sadrirammal/PlantMate-Open-Source/Electrical/02_PlantMate_PCB_V2.1 - swapped pumpen anschlüsse/Screenshot_2.png

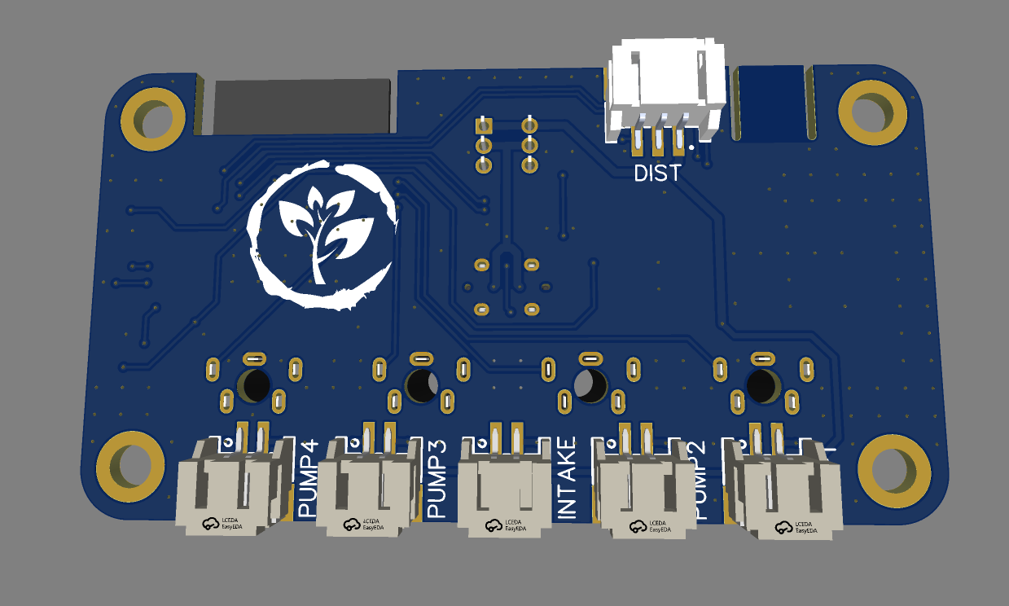
Electrical/02_PlantMate_PCB_V2.1 - swapped pumpen anschlüsse/Screenshot_2.png
