sadrirammal/PlantMate-Open-Source/Electrical/03_Füllstandsensor_V1/Screenshot_1.png

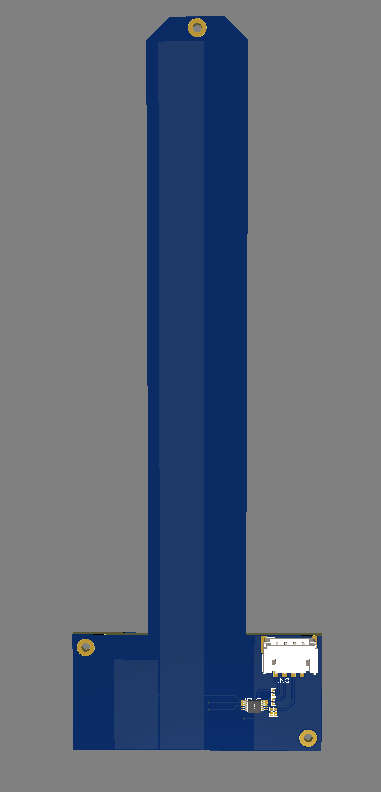
Electrical/03_Füllstandsensor_V1/Screenshot_1.png
