sadrirammal/PlantMate-Open-Source/Electrical/02_PlantMate_PCB_V2.1 - swapped pumpen anschlüsse/BOM.csv

ID | Name | Designator | Footprint | Quantity | Manufacturer Part | Manufacturer | Supplier | Supplier Part
1 | WAFER-PH2.0-2PWB | PUMP1,PUMP2,PUMP3,PUMP4,INTAKE | CONN-SMD_2P-P2.00_XUNPU_WAFER-PH2.0-2PWB | 5 | WAFER-PH2.0-2PWB | XUNPU(讯普) | LCSC | C3029440
2 | WAFER-PH2.0-3PWB | DIST | CONN-SMD_3P-P2.00_XUNPU_WAFER-PH2.0-3PWB | 1 | WAFER-PH2.0-3PWB | XUNPU(讯普) | LCSC | C3029441
3 | 100kΩ | R10,R13,R17,R15,R8 | R0603 | 5 | 0603WAF1003T5E | UNI-ROYAL(厚声) | LCSC | C25803
4 | B5819W | D5,D6,D8,D7,D4 | SOD-123_L2.7-W1.6-LS3.7-RD-1 | 5 | B5819W SL | CJ(江苏长电/长晶) | LCSC | C8598
5 | AO3400A | Q6,Q7,Q9,Q8,Q5 | SOT-23-3_L2.9-W1.3-P1.90-LS2.4-BR | 5 | AO3400A | AOS | LCSC | C20917
6 | TS-1088R-02026 | BOOT,RST | SW-SMD_L3.9-W3.0-P4.45 | 2 | TS-1088R-02026 | XUNPU(讯普) | LCSC | C455280
7 | TYPE-C 24PLT-H10.5 | USB | USB-C_TYPE-C-24PLT-H10.5-1 | 1 | TYPE-C 24PLT-H10.5 | SHOU HAN(首韩) | LCSC | C3151750
8 | 10uF | C10,C5,C4,C9,C1,C2 | C0603 | 6 | CL10A106MA8NRNC | SAMSUNG(三星) | LCSC | C96446
9 | 5.1kΩ | R6,R7 | R0402 | 2 | 0402WGF5101TCE | UniOhm | LCSC | C25905
10 | PJ-358H-B | AUX1,AUX2,AUX3,AUX4 | AUDIO-TH_PJ-358H-B | 4 | PJ-358H-B | XKB Connectivity(中国星坤) | LCSC | C500091
11 | AHT20 | U3 | SENSOR-SMD_L3.0-W3.0-P1.00-BR | 1 | AHT20 | 广州奥松 | LCSC | C2757850
12 | ESP32-WROOM-32E(16MB) | U1 | WIFI-SMD_ESP32-WROOM-32E | 1 | ESP32-WROOM-32E-N16 | ESPRESSIF(乐鑫) | LCSC | C701343
13 | 1MΩ | R22,R21,R20,R19 | R0603 | 4 | 0603WAF1004T5E | UNI-ROYAL(厚声) | LCSC | C22935
14 | CH340C | U7 | SOP-16_L10.0-W3.9-P1.27-LS6.0-BL | 1 | CH340C | WCH | LCSC | C84681
15 | AMS1117-3.3 | U2 | SOT-223-3_L6.5-W3.4-P2.30-LS7.0-BR | 1 | AMS1117-3.3 | AMS | LCSC | C6186
16 | 100n | C3,C7,C8 | C0603 | 3 | CC0603KRX7R9BB104 | YAGEO(国巨) | LCSC | C14663
17 | MUN5214DW1T1G | Q1 | SOT-363_L2.0-W1.3-P0.65-LS2.1-TL | 1 | MUN5214DW1T1G | onsemi(安森美) | LCSC | C94403
18 | 47uF | C6 | CASE-A_3216 | 1 | TAJA476K006RNJ | Kyocera AVX | LCSC | C7190
19 | 5.8 ZSGT | SW1 | SW-TH_5.8ZSGT | 1 | 5.8 ZSGT | SHOU HAN(首韩) | LCSC | C2681587
20 | 0805G (Green) | LED1 | LED0805-R-RD | 1 | KT-0805G | KENTO | LCSC | C2297
21 | 0805R (Red) | LED2 | LED0805-R-RD | 1 | NCD0805R1 | 国星光电 | LCSC | C84256
22 | 0805W (White) | LED3 | LED0805-R-RD | 1 | KT-0805W | KENTO | LCSC | C34499
23 | 30Ω | R2,R18 | R0603 | 2 | 0603WAF300JT5E | UNI-ROYAL(厚声) | LCSC | C22985
24 | 100Ω | R3,R16,R14,R12,R11,R9 | R0603 | 6 | 0603WAF1000T5E | UNI-ROYAL(厚声) | LCSC | C22775
25 | 10kΩ | R4,R5,R1 | R0603 | 3 | 0603WAF1002T5E | UniOhm | LCSC | C25804
