sadrirammal/PlantMate-Open-Source/Electrical/03_Füllstandsensor_V1/BOM.csv

ID | Name | Designator | Footprint | Quantity | Manufacturer Part | Manufacturer | Supplier | Supplier Part
1 | FDC1004DGSR | U1 | MSOP-10 | 1 | FDC1004DGSR | TI(德州仪器) | LCSC | C2865994
2 | 10kΩ | R2,R1 | R0402 | 2 | 0402WGF1002TCE | UNI-ROYAL(厚声) | LCSC | C25744
3 | 1uF | C2 | C0402 | 1 | CL05A105KA5NQNC | SAMSUNG(三星) | LCSC | C52923
4 | 100nF | C1 | C0402 | 1 | CL05B104KO5NNNC | SAMSUNG(三星) | LCSC | C1525
5 | HC-PH-4AWT | CN1 | CONN-SMD_4P-L2.00_HCTL_HC-PH-4AWT | 1 | HC-PH-4AWT | HCTL(华灿天禄) | LCSC | C2845444
