sadrirammal/PlantMate-Open-Source/Electrical/03_Füllstandsensor_V1/3D_PCB.step

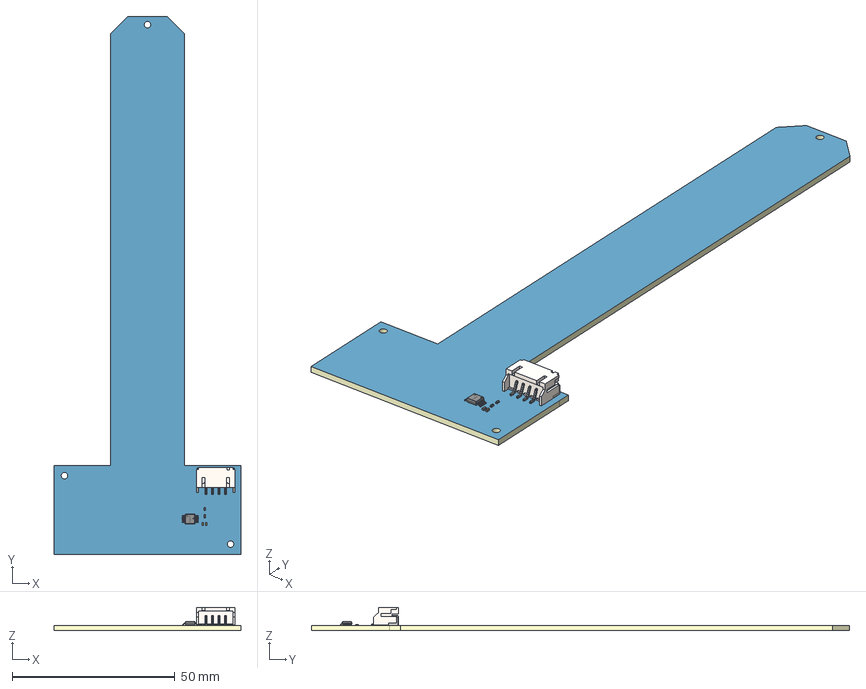
[picture p12: CAD file, 2026-09-02]
Electrical/03_Füllstandsensor_V1/3D_PCB.step
57.4 x 165.2 x 7.15 mm
Board
