sadrirammal/PlantMate-Open-Source/STL/Final_Verschraubung_oben.STEP

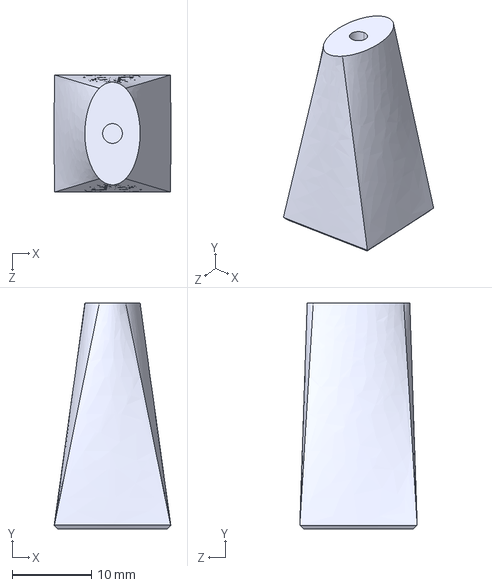
[picture p13: CAD file, 2026-09-02]
STL/Final_Verschraubung_oben.STEP
14.8 x 28.6 x 14.9 mm
