sadrirammal/PlantMate-Open-Source/STL/Final_Verschraubung_unten.STEP

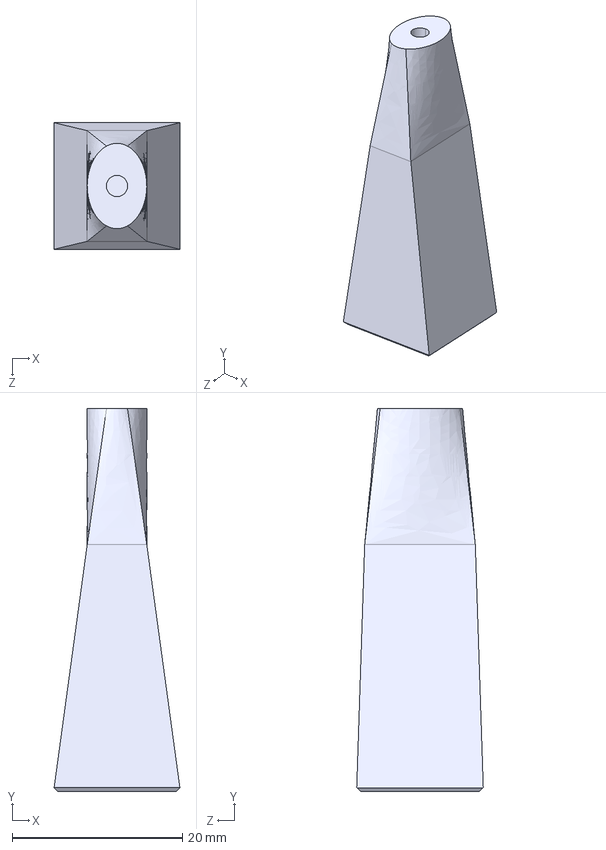
[picture p14: CAD file, 2026-09-02]
STL/Final_Verschraubung_unten.STEP
14.8 x 45.0 x 14.9 mm
