sadrirammal/PlantMate-Open-Source/STL/Lid.STEP

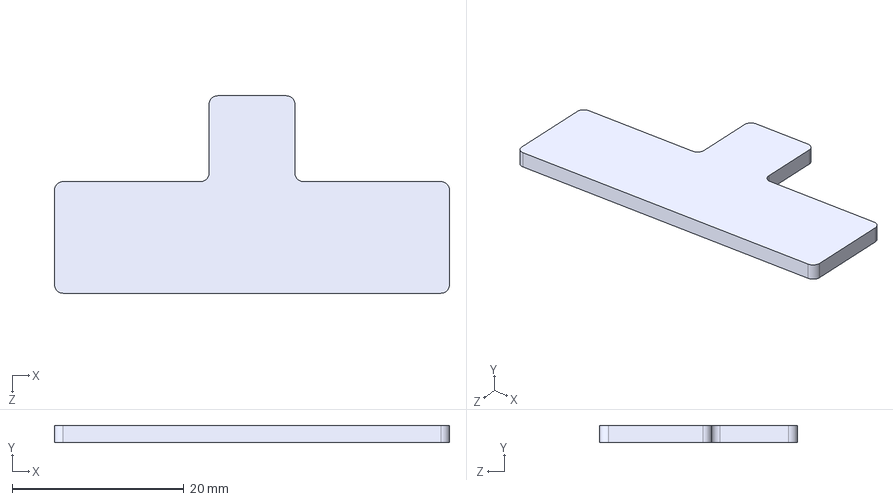
[picture p15: CAD file, 2026-09-02]
STL/Lid.STEP
46.0 x 2.00 x 23.0 mm
