sadrirammal/PlantMate-Open-Source/STL/Ein-Aus-Knopf_klein.STEP

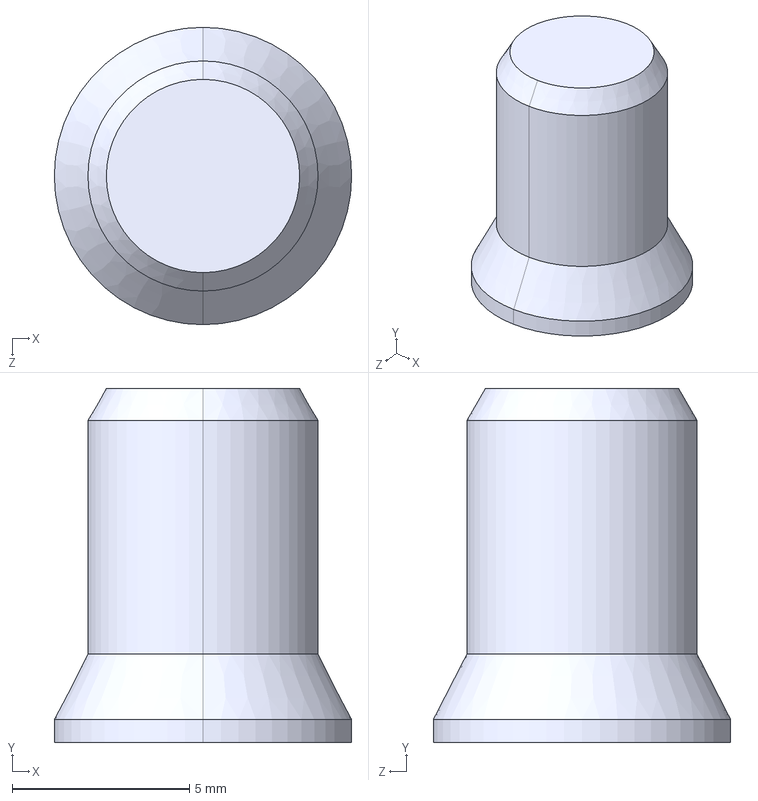
[picture p16: CAD file, 2026-09-02]
STL/Ein-Aus-Knopf_klein.STEP
8.40 x 10.0 x 8.40 mm
