sadrirammal/PlantMate-Open-Source/STL/Final_Tank_2,1.STEP

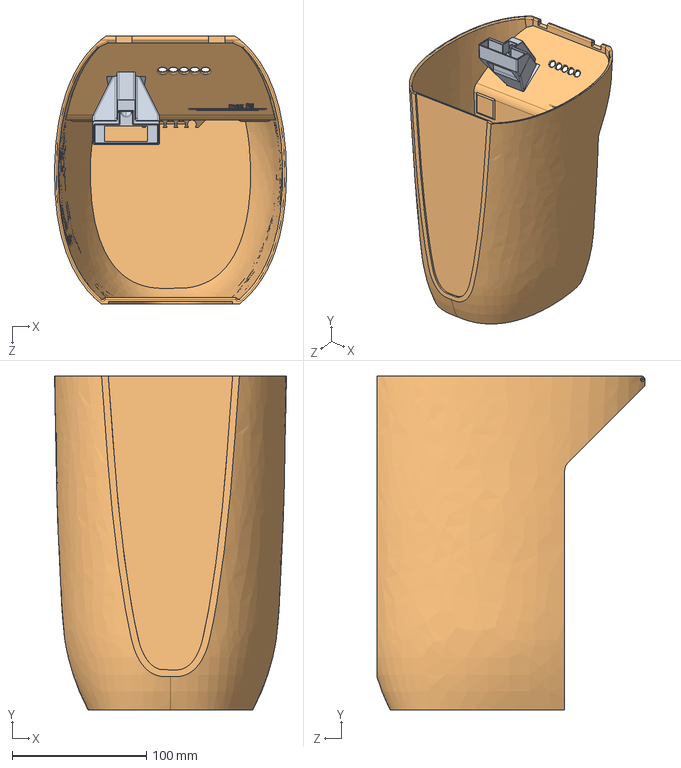
[picture p17: CAD file, 2026-09-02]
STL/Final_Tank_2,1.STEP
173.0 x 249.0 x 200.0 mm
