sadrirammal/PlantMate-Open-Source/STL/Sensor_1.1_seite_1.STEP

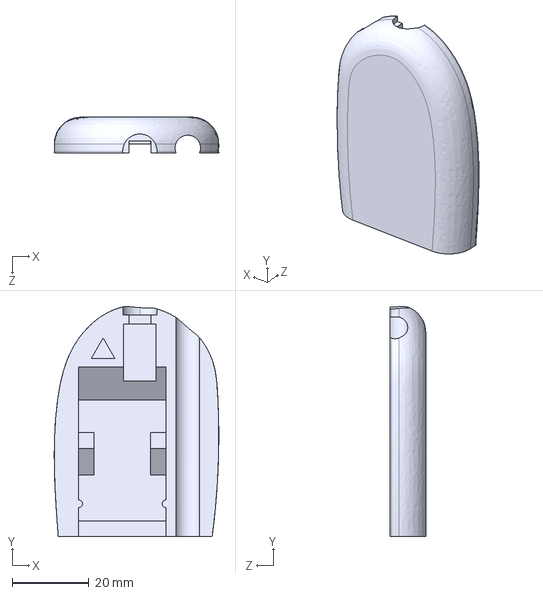
[picture p18: CAD file, 2026-09-02]
STL/Sensor_1.1_seite_1.STEP
42.8 x 59.8 x 9.30 mm
