sadrirammal/PlantMate-Open-Source/STL/Final_Tank_Deckel_203.STEP

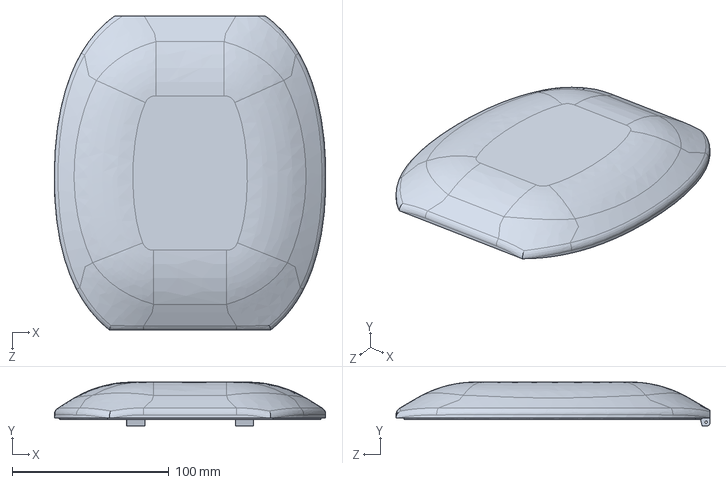
[picture p19: CAD file, 2026-09-02]
STL/Final_Tank_Deckel_203.STEP
172.9 x 28.0 x 200.0 mm
