sadrirammal/PlantMate-Open-Source/STL/Winkelhalterung.STEP

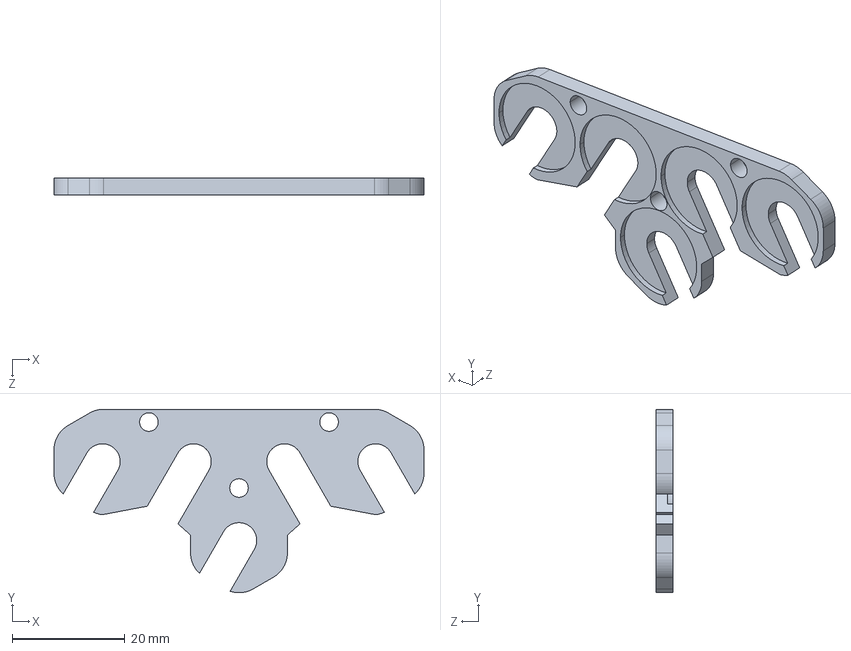
[picture p20: CAD file, 2026-09-02]
STL/Winkelhalterung.STEP
65.7 x 32.6 x 3.00 mm
