sadrirammal/PlantMate-Open-Source/STL/Final_Tank_Rückwand_2,1.STEP

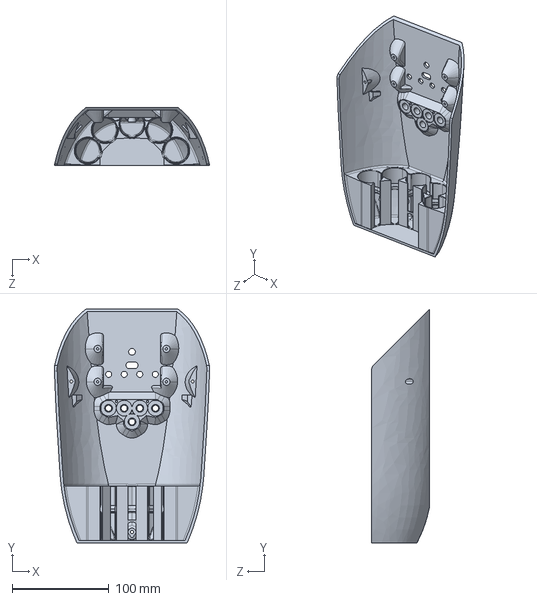
[picture p21: CAD file, 2026-09-02]
STL/Final_Tank_Rückwand_2,1.STEP
160.3 x 241.6 x 60.0 mm
