sadrirammal/PlantMate-Open-Source/STL/Sensor Hauptfassung.STL

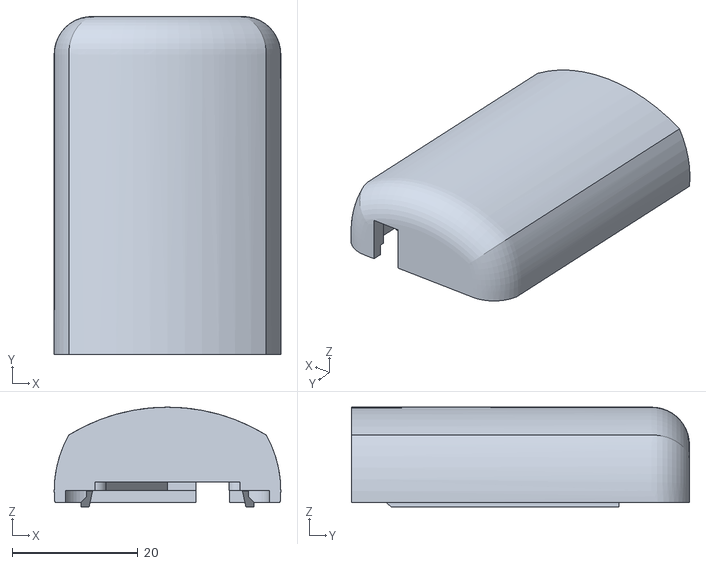
[picture p22: CAD file, 2026-09-02]
STL/Sensor Hauptfassung.STL
36.0 x 53.7 x 15.8
