sadrirammal/PlantMate-Open-Source/STL/Plant_PCB_USB-C.STEP

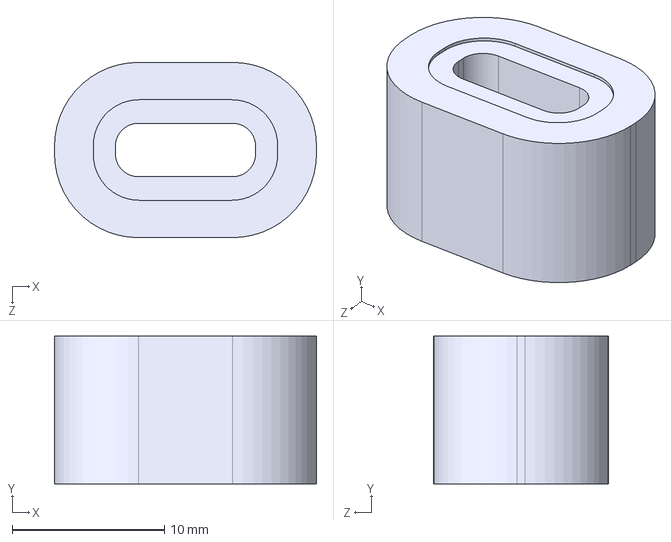
[picture p23: CAD file, 2026-09-02]
STL/Plant_PCB_USB-C.STEP
17.2 x 9.70 x 11.5 mm
