sadrirammal/PlantMate-Open-Source/STL/Sensor_1.1_seite_2.STEP

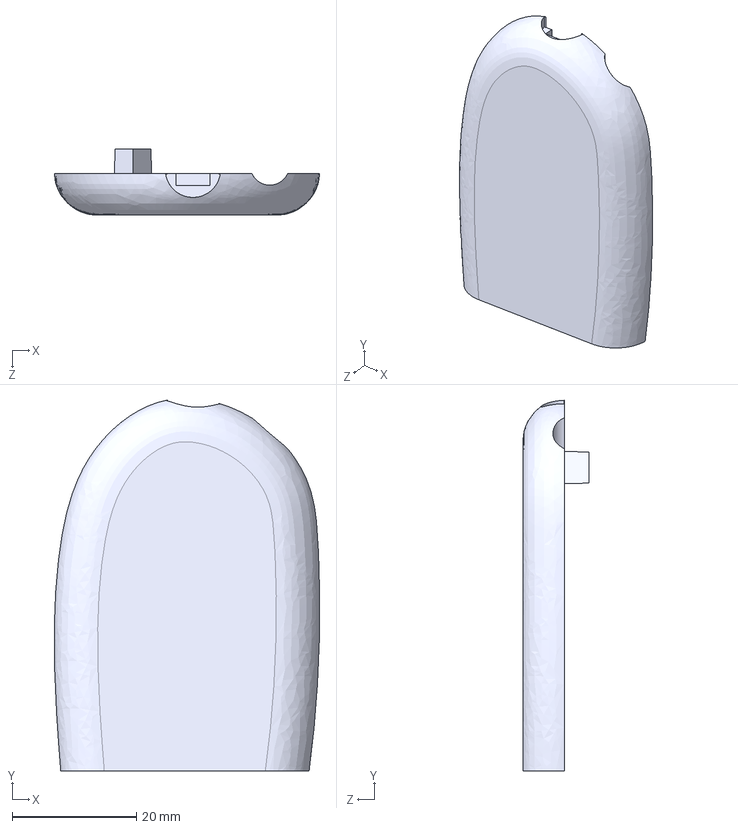
[picture p24: CAD file, 2026-09-02]
STL/Sensor_1.1_seite_2.STEP
42.7 x 59.7 x 10.7 mm
