sadrirammal/PlantMate-Open-Source/STL/Teil23.STEP

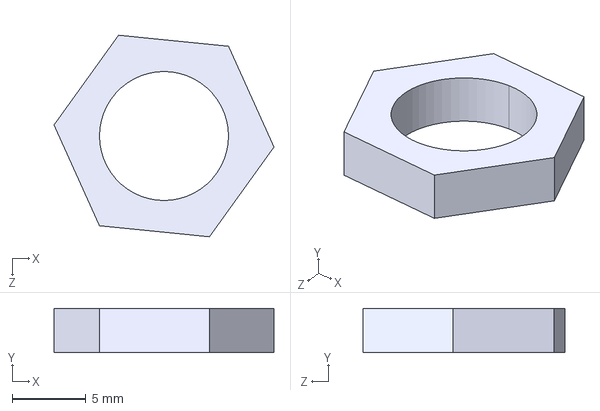
[picture p25: CAD file, 2026-09-02]
STL/Teil23.STEP
14.9 x 3.00 x 13.7 mm
