sadrirammal/PlantMate-Open-Source/STL/Sensor Nebenfassung.STL

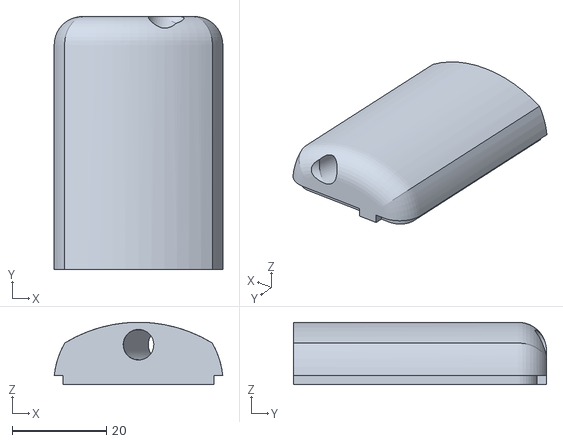
[picture p26: CAD file, 2026-09-02]
STL/Sensor Nebenfassung.STL
35.8 x 53.7 x 13.3
