sadrirammal/PlantMate-Open-Source/Electrical/02_PlantMate_PCB_V2.1 - swapped pumpen anschlüsse/Schematic.pdf

## 3.3v LDO

PUMP1 | PUMP2

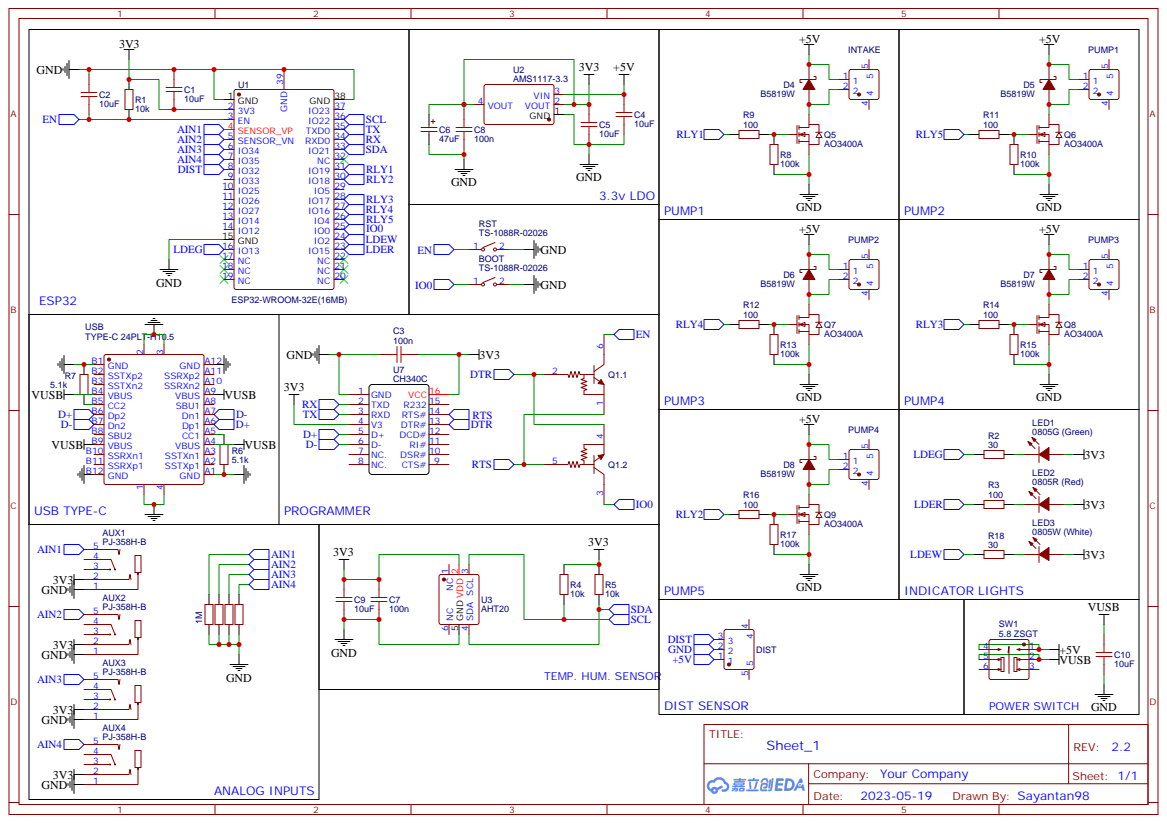
[picture p27: page 1]

GND
GND A1 SSTXp1 A2 SSTXn1 A3 VBUS A4 CC1 A5 Dp1 A6 Dn1 A7 SBU1 A8 VBUS A9 SSRXn2 A10 SSRXp2 A11 GND A12
