sadrirammal/PlantMate-Open-Source/Electrical/03_Füllstandsensor_V1/Schematic.pdf

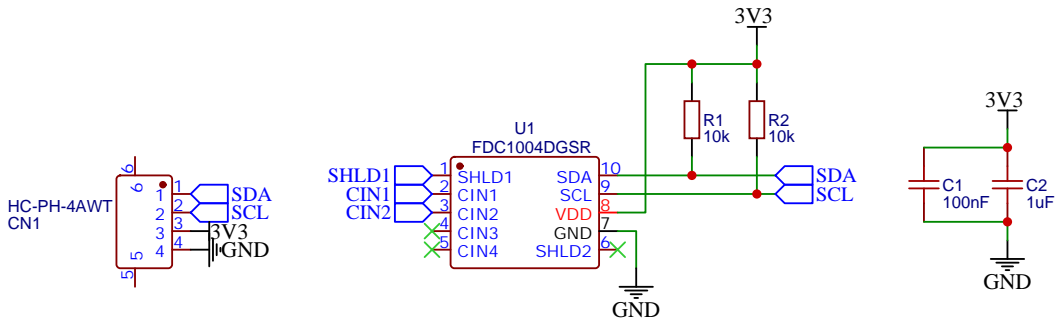
[picture p28: page 1]
