sadrirammal/PlantMate-Open-Source/(commit log)

2026-09-02 Initial open-source release of PlantMate hardware files
    README with known flaws and build notes, PCB V2.1 (schematic, gerber, BOM,
    pick-and-place), capacitive fill-level sensor V1, and STEP/STL files for
    all printed parts.
    Claude-Session: https://claude.ai/code/session_013JP8fTaLoPgp6hqwcXkqH6
    [3D_PCB.step, BOM.csv, Ein-Aus-Knopf_klein.STEP, Final_Tank_2,1.STEP, Final_Tank_Deckel_203.STEP, Final_Tank_Rückwand_2,1.STEP, Final_Verschraubung_oben.STEP, Final_Verschraubung_unten.STEP]
2026-09-02 README: open-source scope, app links, product photos, wiring and BOM details
    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
2026-10-12 Update assembly instructions in Readme.Md
